AkaneCelorrioGonzalvo/Electronica-Artemisa-III/Placa Junio/LIB_LC86LICMD/LC86LICMD/3D/LC86LICMD.stp

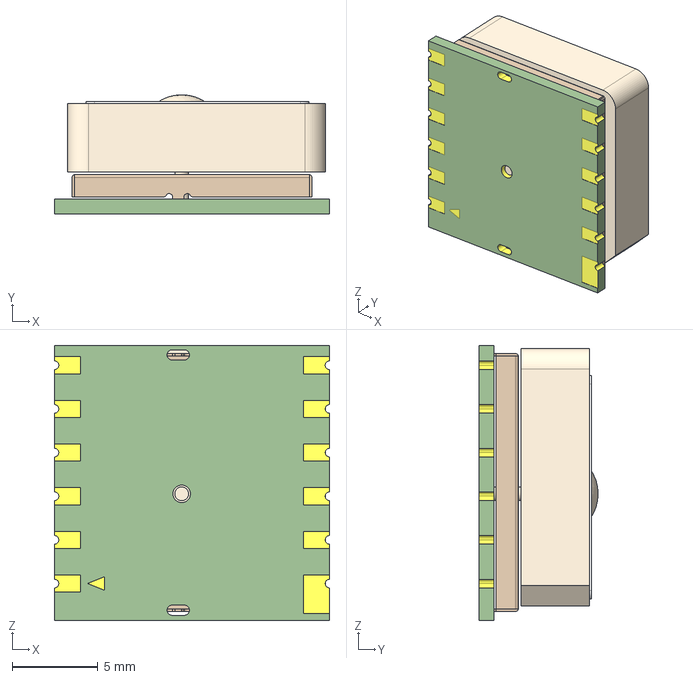
[picture p1: CAD file, 2026-06-18]
Placa Junio/LIB_LC86LICMD/LC86LICMD/3D/LC86LICMD.stp
16.0 x 6.95 x 16.0 mm
