AkaneCelorrioGonzalvo/Electronica-Artemisa-III/(list of files, cad)

Other CAD files:
Placa Junio/LIB_LC86LICMD/LC86LICMD/Allegro/lc86licmd.psm
Placa Junio/LIB_LC86LICMD/LC86LICMD/DEHDL/lc86licmd/chips/chips.prt
