AkaneCelorrioGonzalvo/Electronica-Artemisa-III/(list of files, drawings)

Other design files:
Placa Junio/LIB_LC86LICMD/LC86LICMD/Altium/LC86LICMD.PcbLib
Placa Junio/LIB_LC86LICMD/LC86LICMD/Altium/LC86LICMD.SchLib
