AkaneCelorrioGonzalvo/Electronica-Artemisa-III/Placa Junio/PlacaJunio/PlacaJunio.kicad_pcb

## KiCad design Placa Junio/PlacaJunio/PlacaJunio.kicad_pcb (2026-06-30)

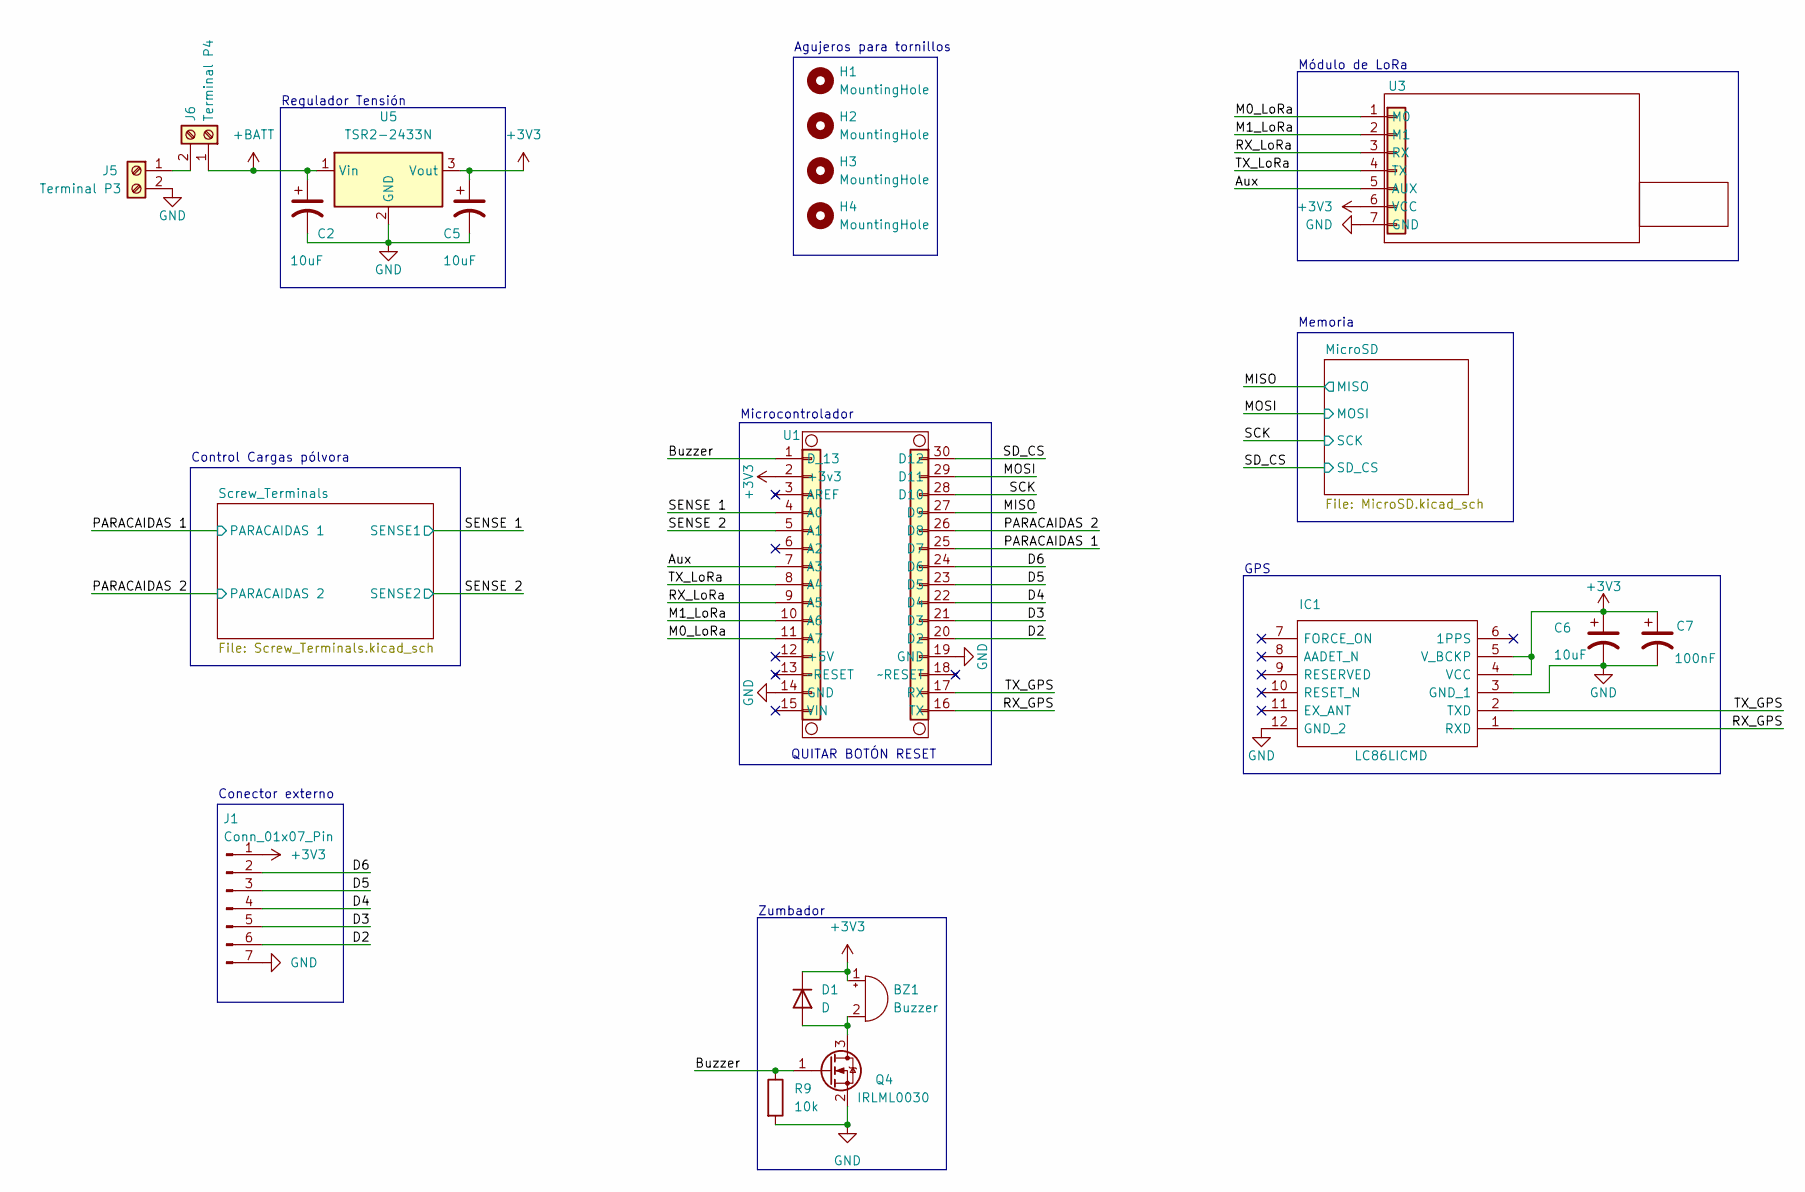
[picture p2: schematic PlacaJunio.kicad_sch]

Parts:
BZ1: Buzzer; MagneticBuzzer_CUI_CMT-8504-100-SMT
C2, C5, C6: 10uF; C_1206_3216Metric_Pad1.33x1.80mm_HandSolder
C7: 100nF; C_1206_3216Metric_Pad1.33x1.80mm_HandSolder
D1: D; D_0805_2012Metric
H1, H2, H3, H4: MountingHole; MountingHole_3.2mm_M3_DIN965
IC1: LC86LICMD; Mouser Part Number 277-LC86LICMD
J1: Conn_01x07_Pin; PinHeader_1x07_P2.54mm_Vertical
J5: Terminal P3; TerminalBlock_bornier-2_P5.08mm
J6: Terminal P4; TerminalBlock_bornier-2_P5.08mm
Q4: IRLML0030; SOT-23
R9: 10k; R_0402_1005Metric
U1: Nano BLE 33 Sense
U3: LoRa
U5: TSR2-2433N; Converter_DCDC_TRACO_TSR2-24xxN_TSR2-24xxxN_THT

Connections:
+3V3: BZ1.1 (+), C5.1, C6.1, C7.1, D1.1 (K), IC1.4 (VCC), IC1.5 (V_BCKP), J1.1, U1.2 (+3v3), U3.6 (VCC), U5.3 (Vout); also elsewhere on the board
+BATT: C2.1, J6.1, U5.1 (Vin)
/Aux: U1.7 (A3), U3.5 (AUX)
/Buzzer: Q4.1 (G), R9.1, U1.1 (D_13)
/D2: J1.6, U1.20 (D2)
/D3: J1.5, U1.21 (D3)
/D4: J1.4, U1.22 (D4)
/D5: J1.3, U1.23 (D5)
/D6: J1.2, U1.24 (D6)
/M0_LoRa: U1.11 (A7), U3.1 (M0)
/M1_LoRa: U1.10 (A6), U3.2 (M1)
/MISO: U1.27 (D9); also elsewhere on the board
/MOSI: U1.29 (D11); also elsewhere on the board
/PARACAIDAS 1: U1.25 (D7); also elsewhere on the board
/PARACAIDAS 2: U1.26 (D8); also elsewhere on the board
/RX_GPS: IC1.1 (RXD), U1.16 (TX)
/RX_LoRa: U1.9 (A5), U3.3 (RX)
/SCK: U1.28 (D10); also elsewhere on the board
/SD_CS: U1.30 (D12); also elsewhere on the board
/SENSE 1: U1.4 (A0); also elsewhere on the board
/SENSE 2: U1.5 (A1); also elsewhere on the board
/TX_GPS: IC1.2 (TXD), U1.17 (RX)
/TX_LoRa: U1.8 (A4), U3.4 (TX)
GND: C2.2, C5.2, C6.2, C7.2, IC1.3 (GND_1), IC1.12 (GND_2), J1.7, J5.2, Q4.2 (S), R9.2, U1.14 (GND), U1.19 (GND), U3.7 (GND), U5.2 (GND); also elsewhere on the board
unnamed: BZ1.2 (-), D1.2 (A), Q4.3 (D)
unnamed: J5.1, J6.2

Notes on the sheet:
GPS
Zumbador
Módulo de LoRa
Regulador Tensión
Memoria
QUITAR BOTÓN RESET
Microcontrolador
Control Cargas pólvora
Agujeros para tornillos
Conector externo

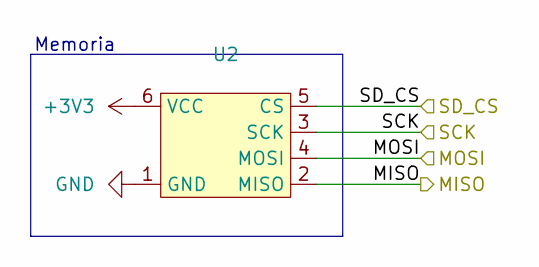
[picture p3: schematic MicroSD.kicad_sch]

Parts:
U2: MicroSD

Connections:
+3V3: U2.6 (VCC); also elsewhere on the board
/MISO: U2.2 (MISO); also elsewhere on the board
/MOSI: U2.4 (MOSI); also elsewhere on the board
/SCK: U2.3 (SCK); also elsewhere on the board
/SD_CS: U2.5 (CS); also elsewhere on the board
GND: U2.1 (GND); also elsewhere on the board

Notes on the sheet:
Memoria

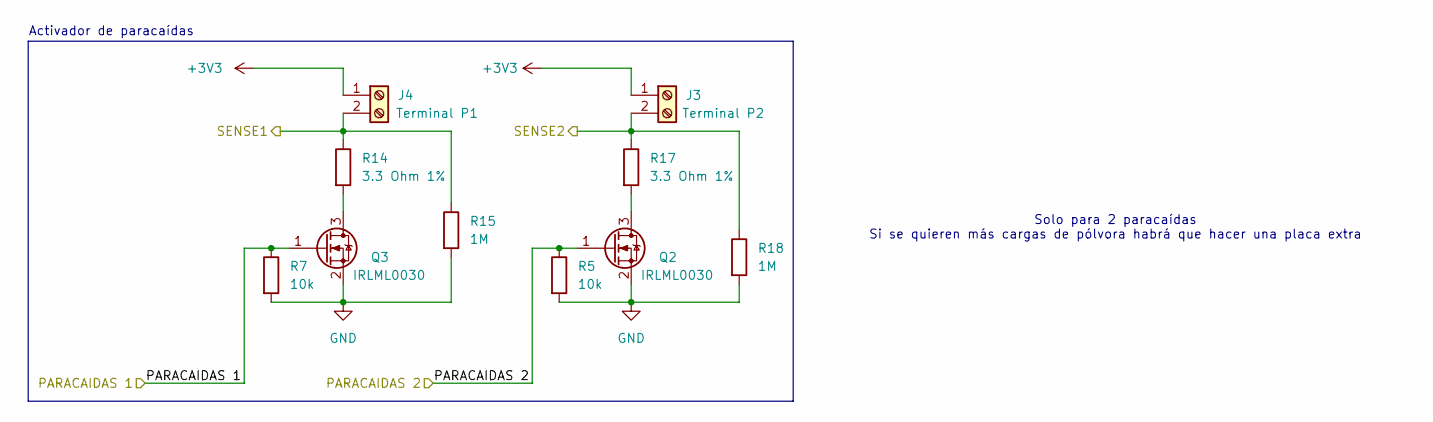
[picture p4: schematic Screw_Terminals.kicad_sch]

Parts:
J3: Terminal P2; TerminalBlock_bornier-2_P5.08mm
J4: Terminal P1; TerminalBlock_bornier-2_P5.08mm
Q2, Q3: IRLML0030; SOT-23
R5, R7: 10k; R_0402_1005Metric
R14, R17: 3.3 Ohm 1%; R_0805_2012Metric
R15, R18: 1M; R_0402_1005Metric

Connections:
+3V3: J3.1, J4.1; also elsewhere on the board
/PARACAIDAS 1: Q3.1 (G), R7.1; also elsewhere on the board
/PARACAIDAS 2: Q2.1 (G), R5.1; also elsewhere on the board
/SENSE 1: J4.2, R14.1, R15.1; also elsewhere on the board
/SENSE 2: J3.2, R17.1, R18.1; also elsewhere on the board
GND: Q2.2 (S), Q3.2 (S), R5.2, R7.2, R15.2, R18.2; also elsewhere on the board
unnamed: Q2.3 (D), R17.2
unnamed: Q3.3 (D), R14.2

Notes on the sheet:
Solo para 2 paracaídas Si se quieren más cargas de pólvora habrá que hacer una placa extra
Activador de paracaídas

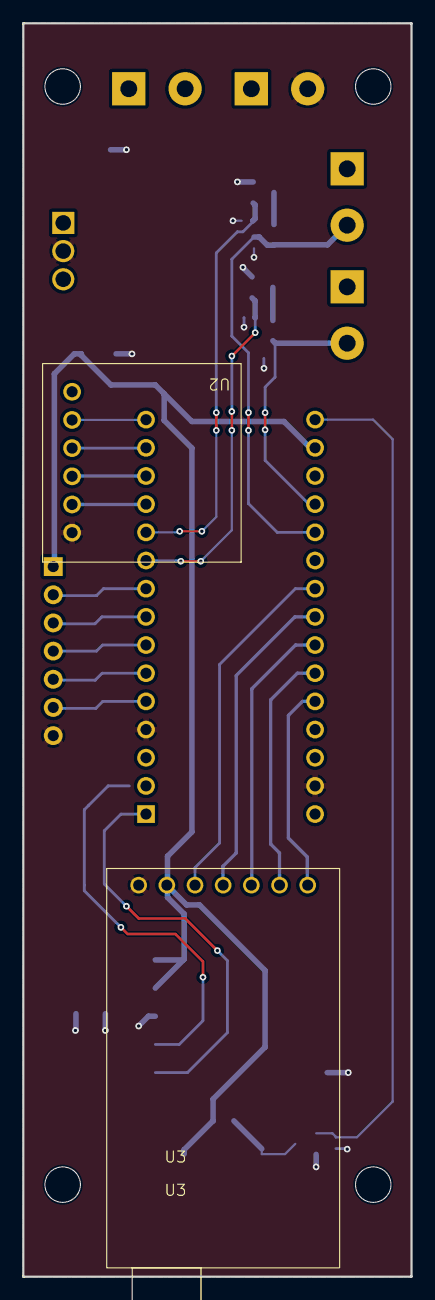
[picture p5: board PlacaJunio.kicad_pcb from above]

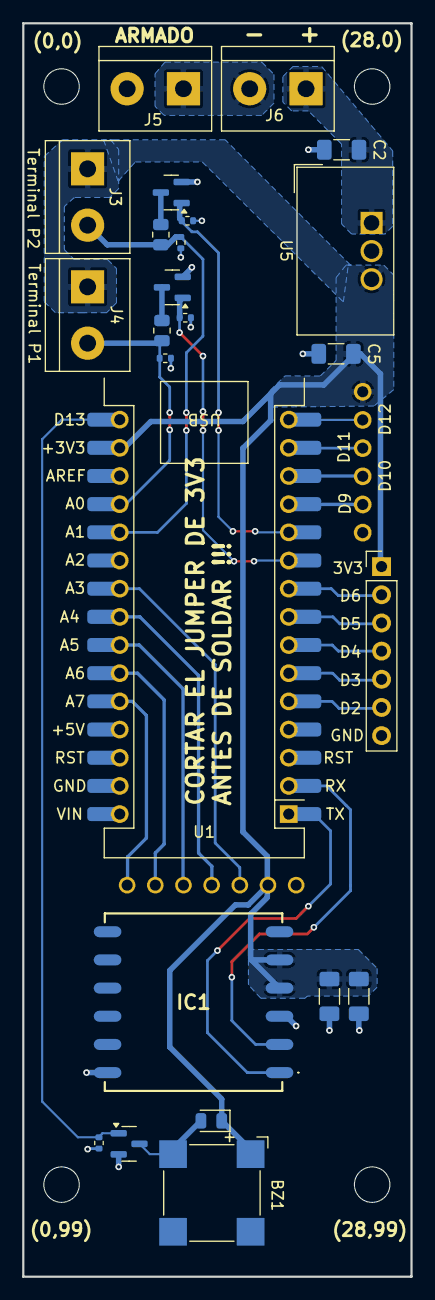
[picture p6: board PlacaJunio.kicad_pcb from below]

Board: 2 copper layers, 35.0 x 113.0 mm, 30 parts (28 on the bottom side), 28 nets.
