AkaneCelorrioGonzalvo/Electronica-Artemisa-III/Placa Junio/Emisor_Avionica/Emisor_Avionica.ino

#include "Config.h"
#include "Globals.h"
#include "Sensores.h"
#include "ControlVuelo.h"
#include "Comunicaciones.h"

#include <rtos.h>

using namespace rtos;

// ============================================================
// HILOS (THREADS) DE RTOS
// ============================================================
Thread hilosSensores(osPriorityAboveNormal);    
Thread hiloGPS(osPriorityNormal);              
Thread hiloControlVuelo(osPriorityHigh);       
Thread hiloTelemetria(osPriorityHigh);  

void setup() {
    delay(2000);
    
    D_PRINTLN("Inicializando Comunicaciones...");
    inicializarComunicaciones();

    inicializarSD();
    inicializarSensores();
    inicializarControlVuelo();

    // Semilla aleatoria usando reloj interno
    randomSeed(micros()); 

    // Arranque concurrente de tareas RTOS
    hilosSensores.start(taskSensores);
    hiloGPS.start(taskGPS);
    hiloControlVuelo.start(taskControlVuelo);
    hiloTelemetria.start(taskTelemetria);
}

void loop() {
    // Dormir el hilo principal para liberar ciclos de CPU
    ThisThread::sleep_for(std::chrono::milliseconds(1000)); 
}
