AkaneCelorrioGonzalvo/Electronica-Artemisa-III/(commit log)

2026-06-18 Cambios PCB
    [EDI2CAP.CFG, LC86LICMD.PcbLib, LC86LICMD.SchLib, LC86LICMD.stp, PlacaJunio.kicad_sch, chips.prt, lc86licmd.psm]
2026-06-23 Update Placa
    [PlacaJunio.kicad_sch]
2026-06-23 Schematic distinto
2026-06-23 Esquemático Completo
    [MicroSD.kicad_sch, PlacaJunio.kicad_pcb, PlacaJunio.kicad_sch]
2026-06-30 Cambios recientes
    [PlacaJunio.kicad_pcb, PlacaJunio.kicad_sch]
2026-06-30 Actualización Con Placa Dani 1/2
    [EDI2CAP.CFG, LC86LICMD.PcbLib, LC86LICMD.SchLib, LC86LICMD.stp, MicroSD.kicad_sch, PlacaJunio.kicad_pcb, PlacaJunio.kicad_sch, Screw_Terminals.kicad_sch]
2026-06-30 Cambios Placa Daniel 2/2
    [EDI2CAP.CFG, LC86LICMD.PcbLib, LC86LICMD.SchLib, LC86LICMD.stp, MicroSD.kicad_sch, PlacaJunio.kicad_pcb, PlacaJunio.kicad_sch, Screw_Terminals.kicad_sch]
2026-10-28 Pruebas porque el LoRa funciona, al parecer, WTF
2026-11-03 Actualización congruencia PCB
